16mhz8bit/stargazer/technical/main electronics board rendering.png

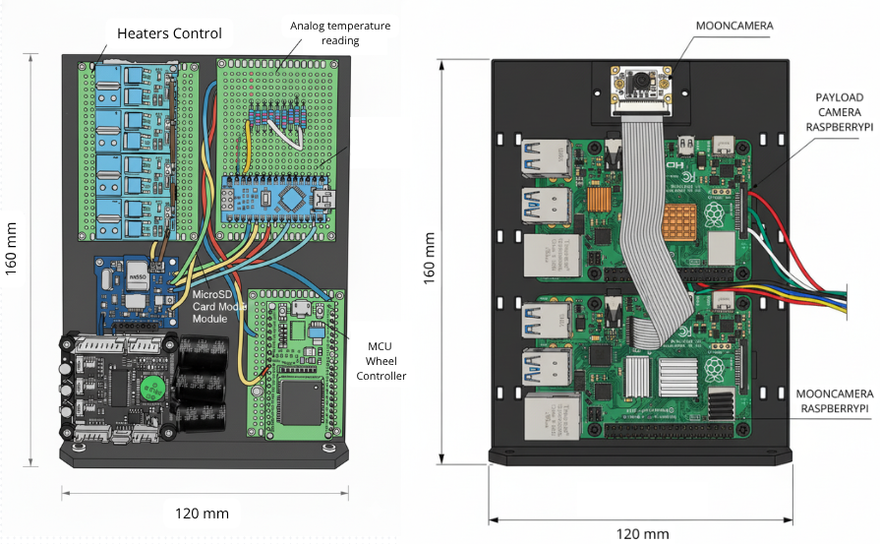
technical/main electronics board rendering.png
