16mhz8bit/stargazer/gallery/main_electronics_bay.jpg

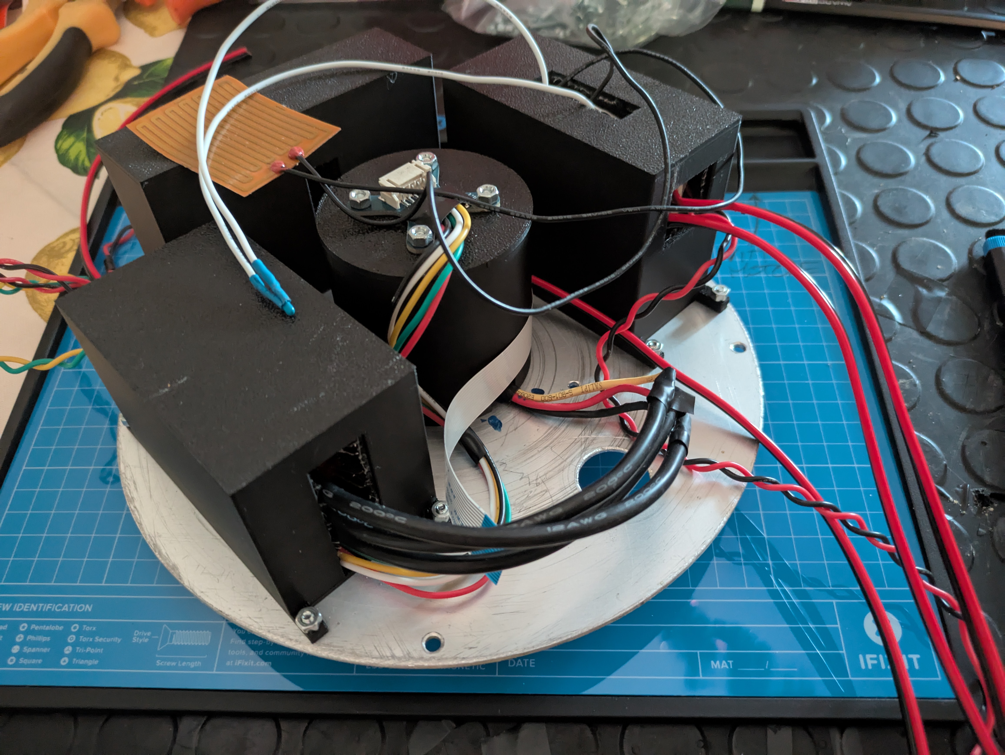
gallery/main_electronics_bay.jpg
