16mhz8bit/stargazer/README.md

# STARGAZER
Aggiungi un titolo (3)

## What's this?  
**STARGAZER** is a self-developed telescope project born from the dream of building a space telescope. 
With limited resources, we turned to high-altitude ballooning as the most accessible way to approach space-like observation conditions. 
Built with simplicity and robustness in mind, Stargazer aims to deliver meaningful scientific data while sharing every step openly to inspire and support the scientific and educational community.

## Sponsor  
Thanks to **SAPIO** for providing the gas for the mission!

logo_sapio
