16mhz8bit/stargazer/gallery/cameras.jpg

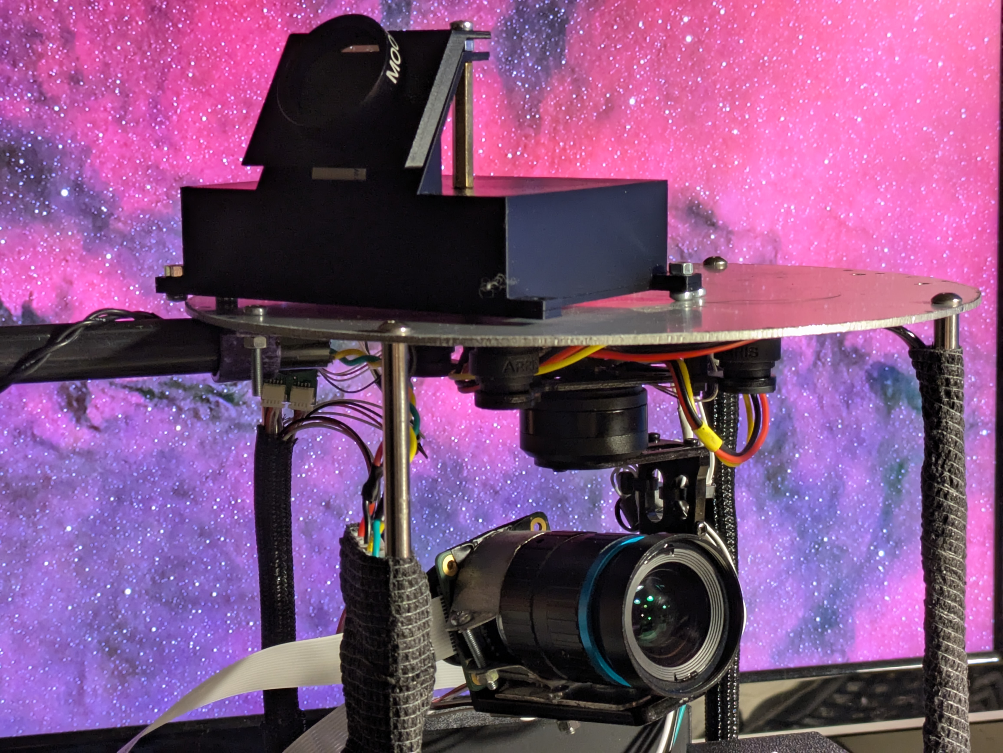
gallery/cameras.jpg
