16mhz8bit/stargazer/gallery/cover.png

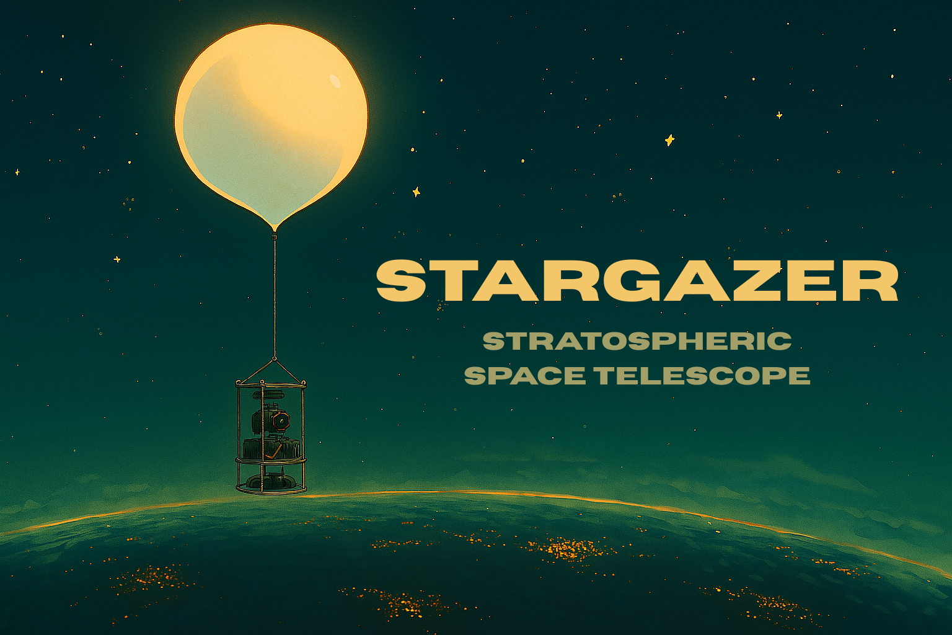
gallery/cover.png
