16mhz8bit/stargazer/gallery/moon_cam_dev.jpg

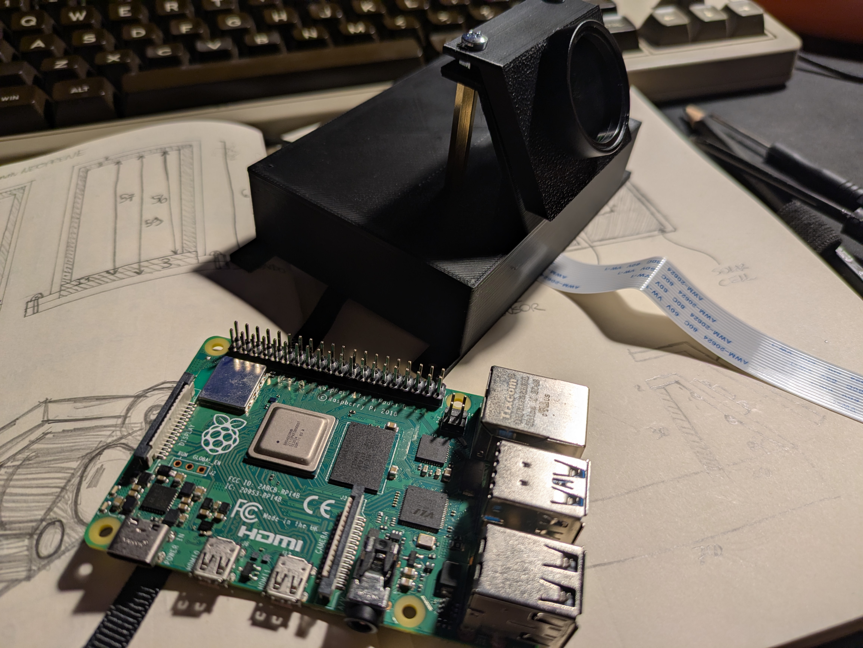
gallery/moon_cam_dev.jpg
