16mhz8bit/stargazer/gallery/power_supply_system.jpg

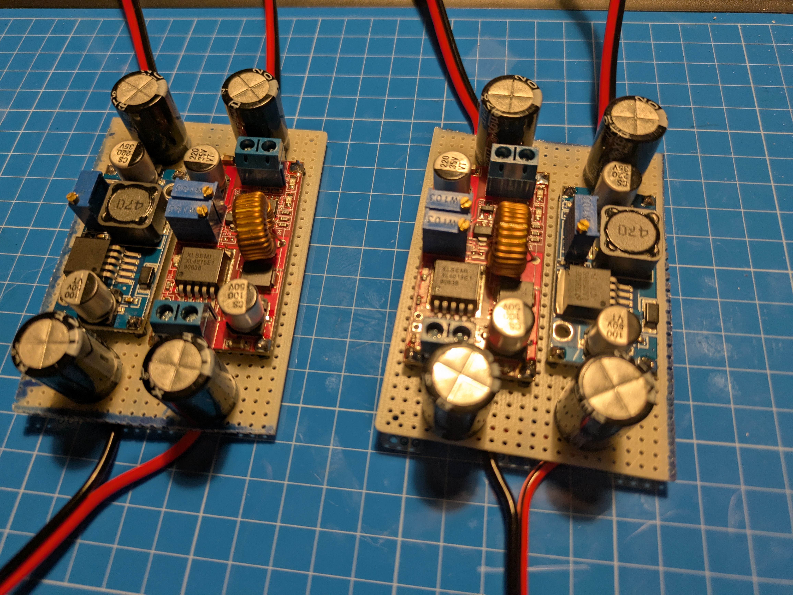
gallery/power_supply_system.jpg
