16mhz8bit/stargazer/gallery/stargazer_dev.jpg

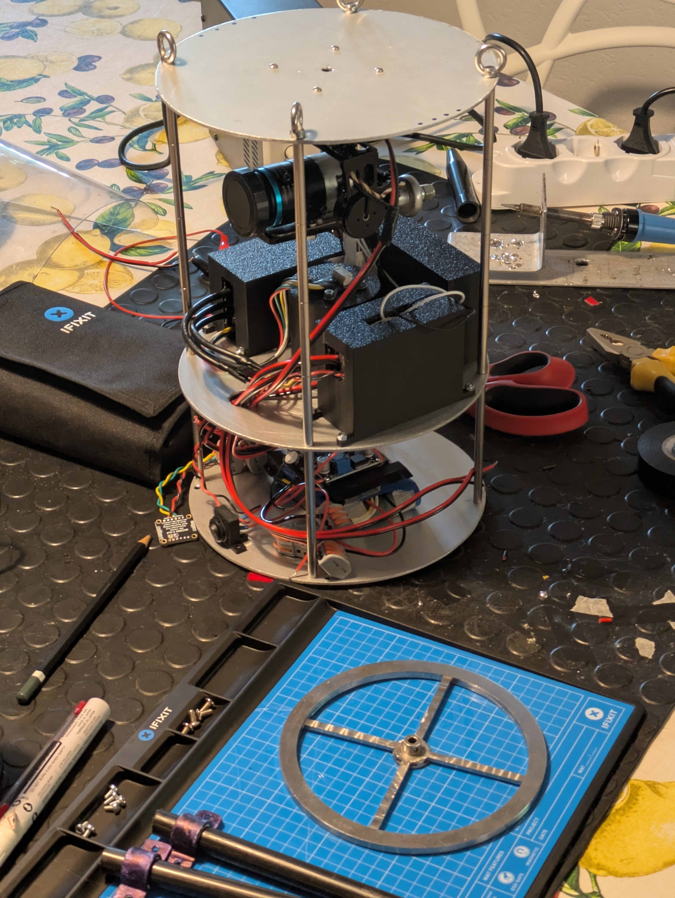
gallery/stargazer_dev.jpg
