16mhz8bit/stargazer/gallery/team_photo.jpg

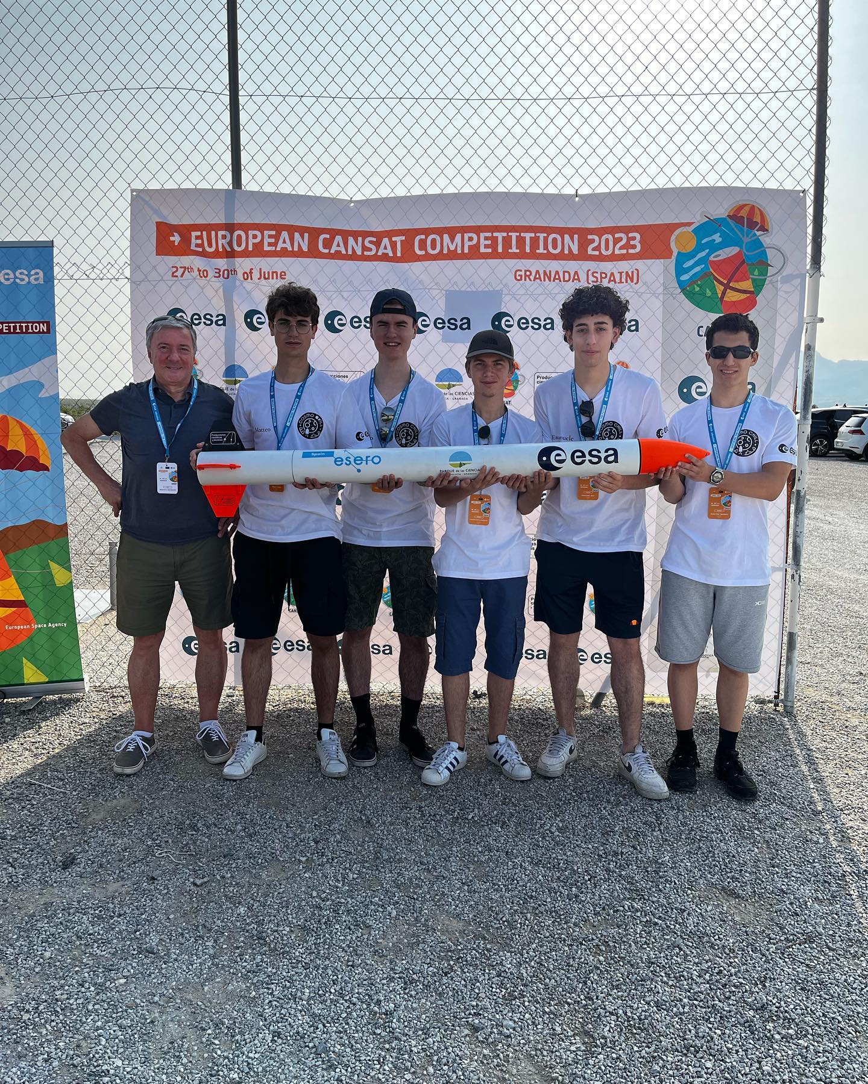
gallery/team_photo.jpg
