16mhz8bit/stargazer/gallery/team_rocket.jpg

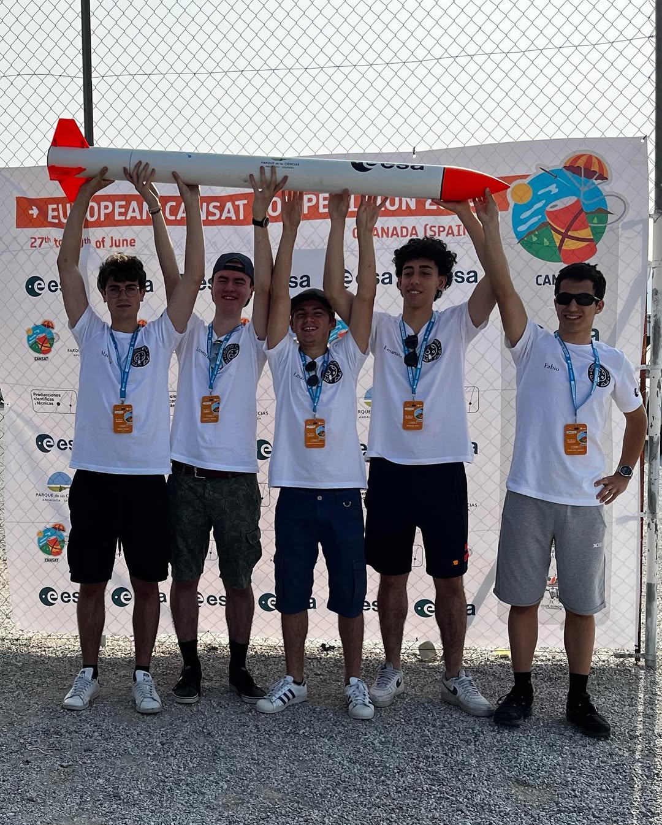
gallery/team_rocket.jpg
