16mhz8bit/stargazer/mooncamera/imgs/1.jpg

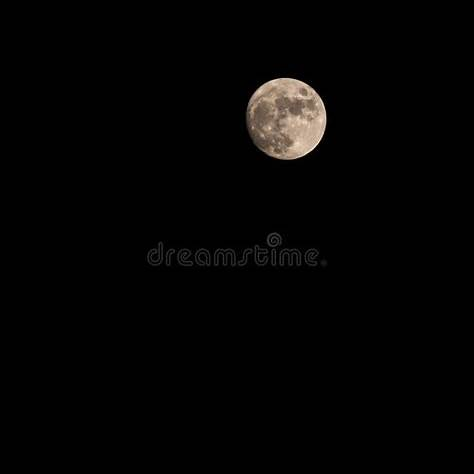
mooncamera/imgs/1.jpg
