16mhz8bit/stargazer/mooncamera/imgs/2.jpg

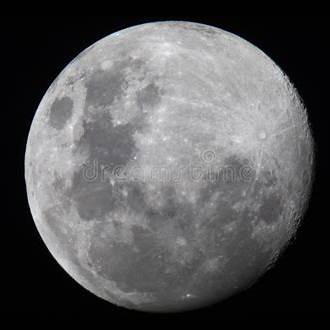
mooncamera/imgs/2.jpg
