16mhz8bit/stargazer/mooncamera/imgs/3.jpg

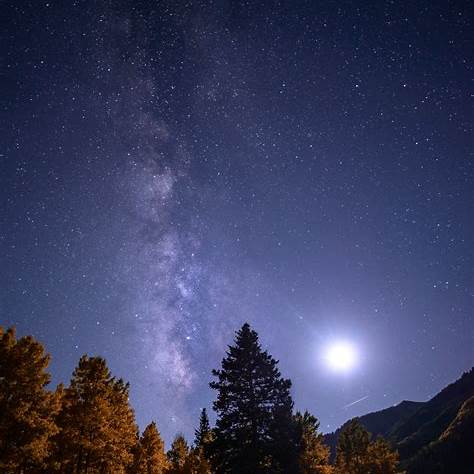
mooncamera/imgs/3.jpg
