16mhz8bit/stargazer/mooncamera/imgs/4.jpg

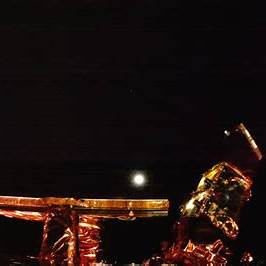
mooncamera/imgs/4.jpg
