16mhz8bit/stargazer/mooncamera/imgs/5.jpeg

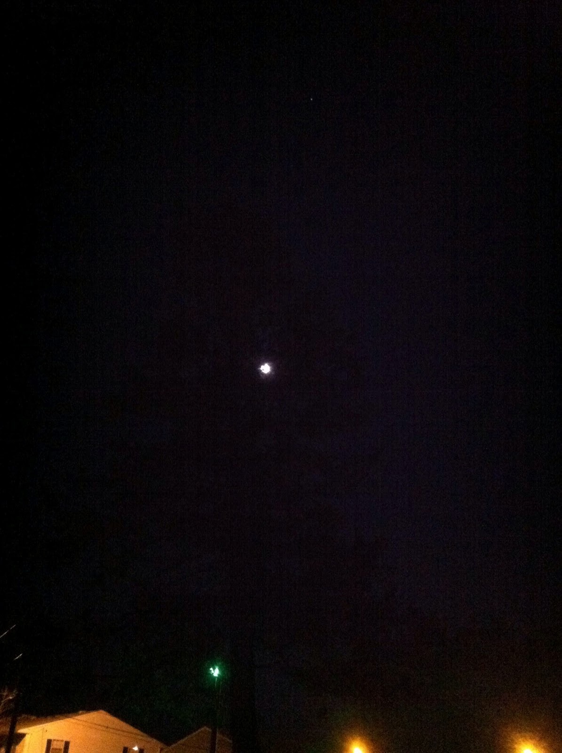
mooncamera/imgs/5.jpeg
