16mhz8bit/stargazer/mooncamera/imgs/7.jpeg

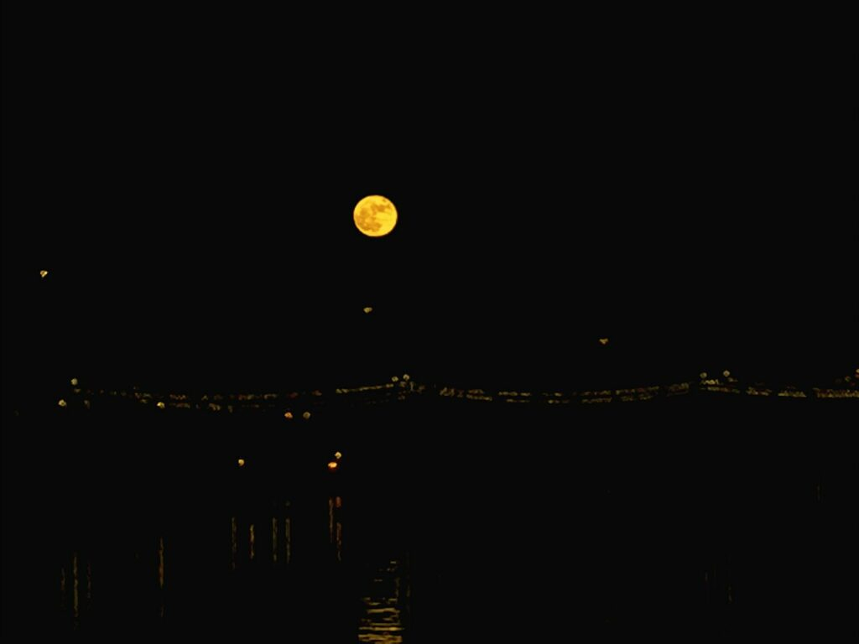
mooncamera/imgs/7.jpeg
