16mhz8bit/stargazer/mooncamera/imgs/8.jpeg

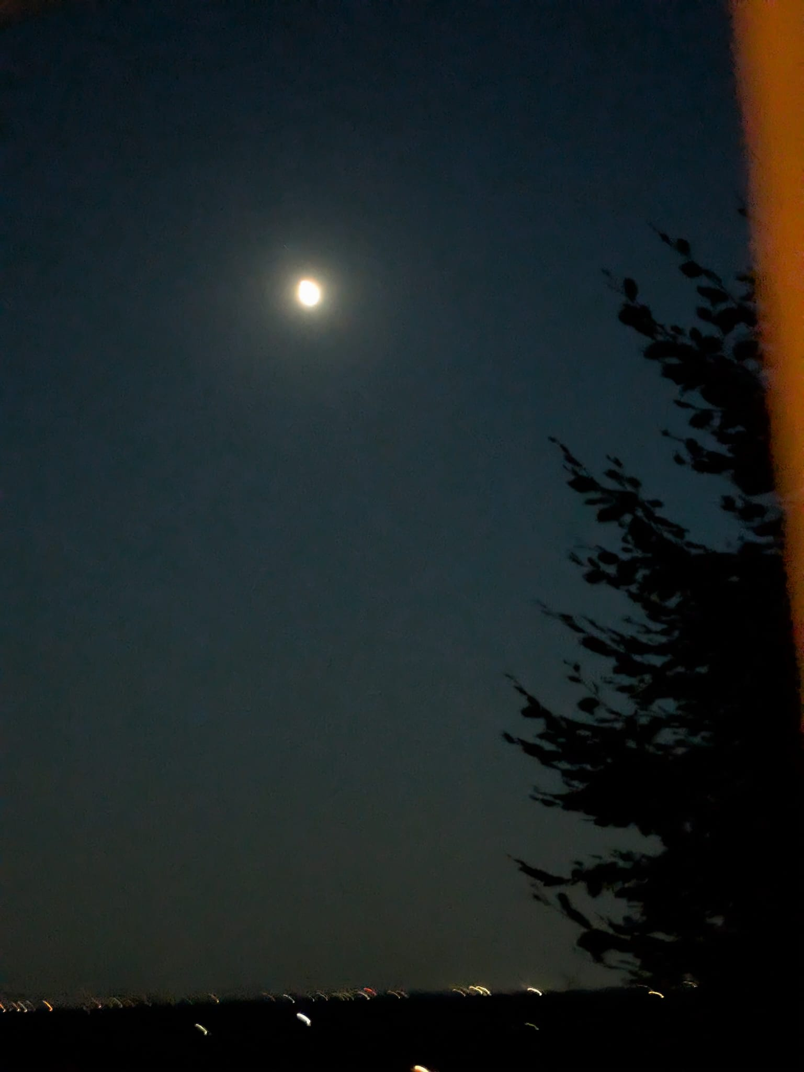
mooncamera/imgs/8.jpeg
