16mhz8bit/stargazer/mooncamera/imgs/9.jpeg

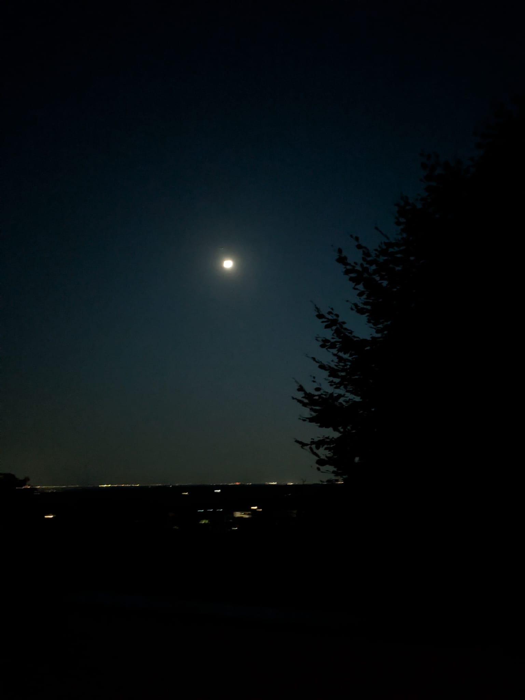
mooncamera/imgs/9.jpeg
