16mhz8bit/stargazer/mooncamera/imgs/11.jpeg

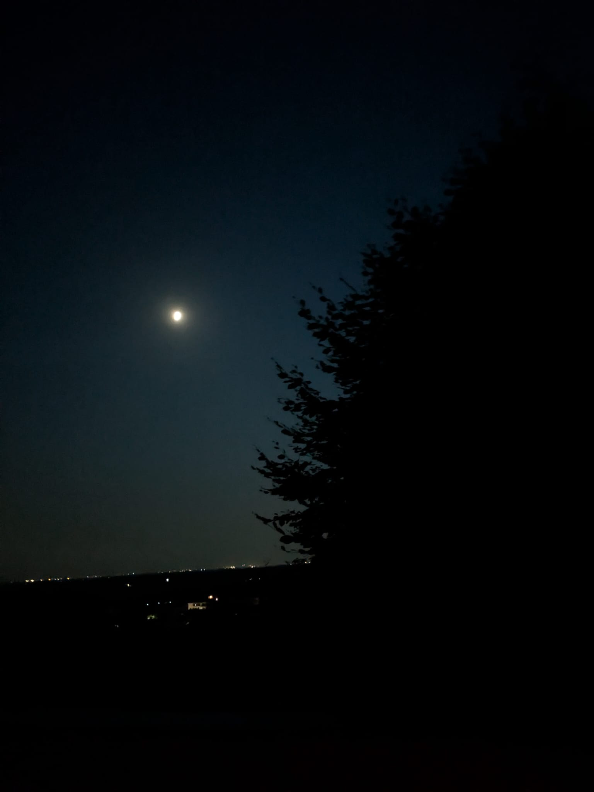
mooncamera/imgs/11.jpeg
