16mhz8bit/stargazer/mooncamera/imgs/12.jpeg

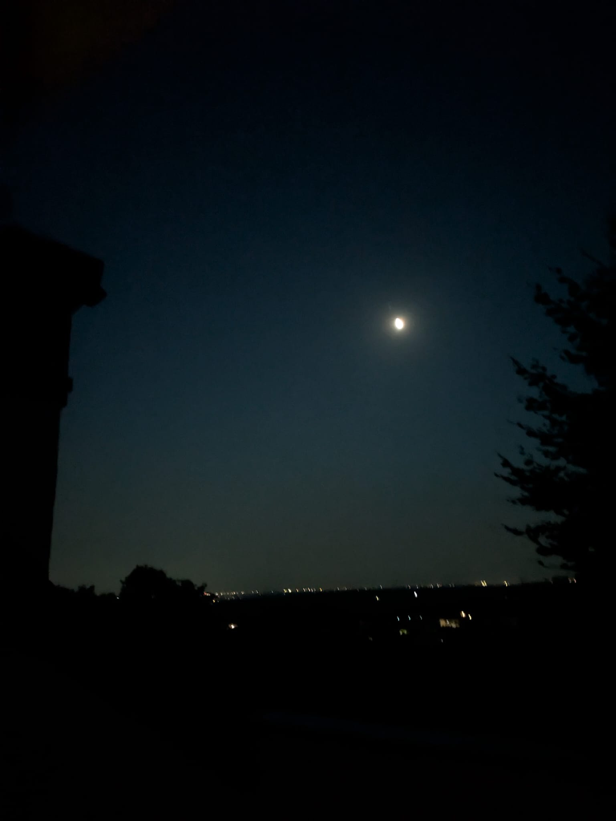
mooncamera/imgs/12.jpeg
