16mhz8bit/stargazer/mooncamera/imgs/13.jpeg

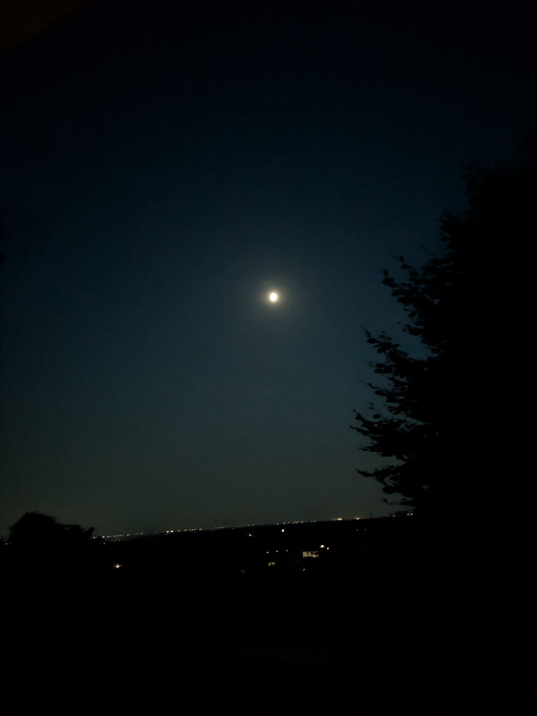
mooncamera/imgs/13.jpeg
