16mhz8bit/stargazer/mooncamera/imgs/14.jpeg

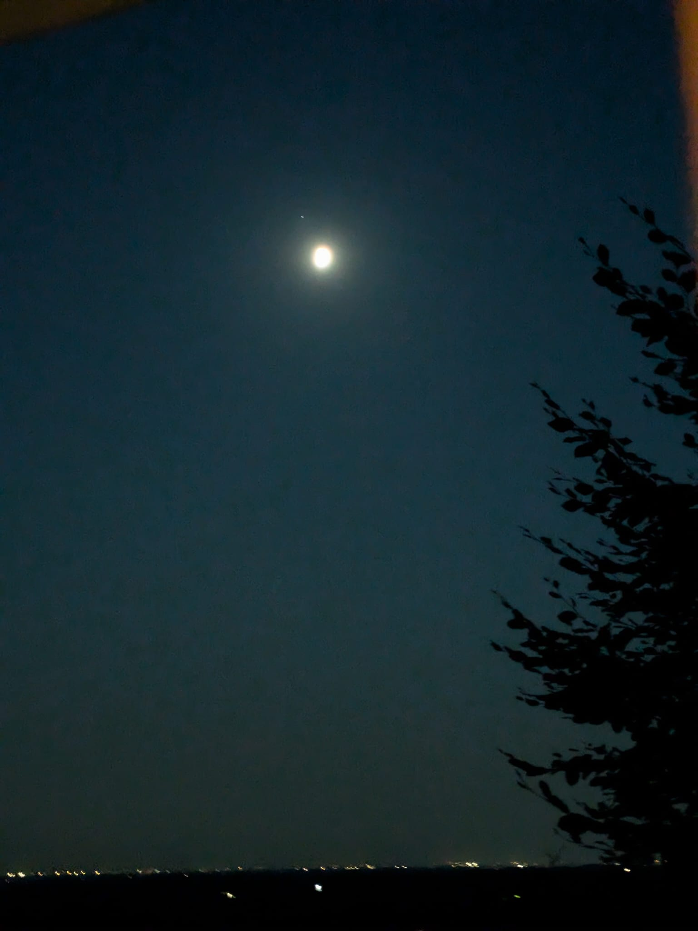
mooncamera/imgs/14.jpeg
