16mhz8bit/stargazer/technical/main electronics board.png

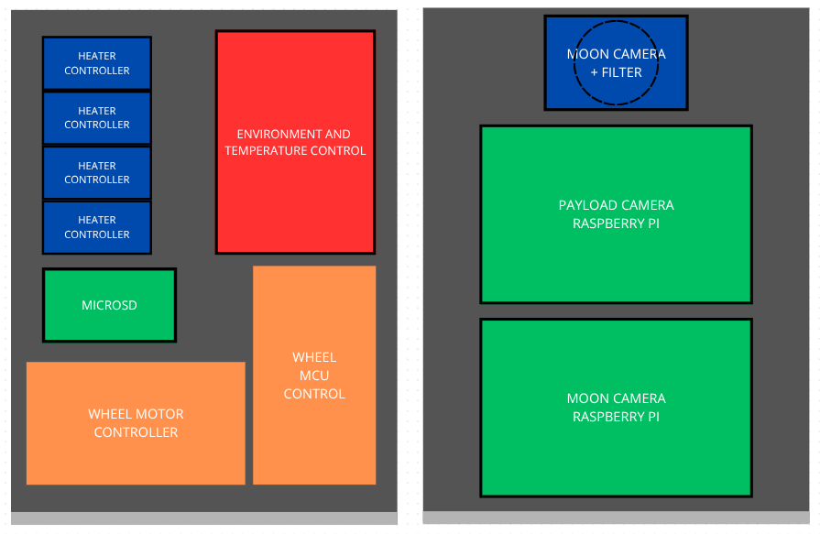
technical/main electronics board.png
