16mhz8bit/stargazer/technical/3D files/Wheel motor enclosure (with encoder holes).stl

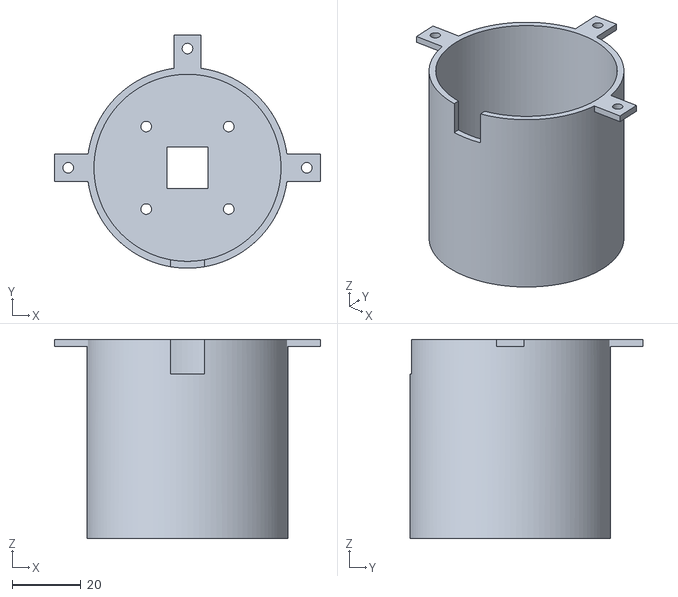
[picture p29: CAD file, 2025-10-27]
technical/3D files/Wheel motor enclosure (with encoder holes).stl
77.5 x 68.0 x 58.0
