16mhz8bit/stargazer/technical/3D files/Board for cameras electronics.stl

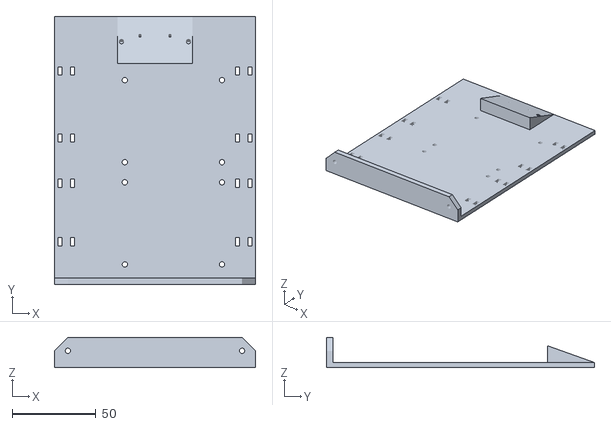
[picture p30: CAD file, 2025-10-27]
technical/3D files/Board for cameras electronics.stl
120.0 x 160.0 x 18.0
