16mhz8bit/stargazer/technical/3D files/Board for control electronics.stl

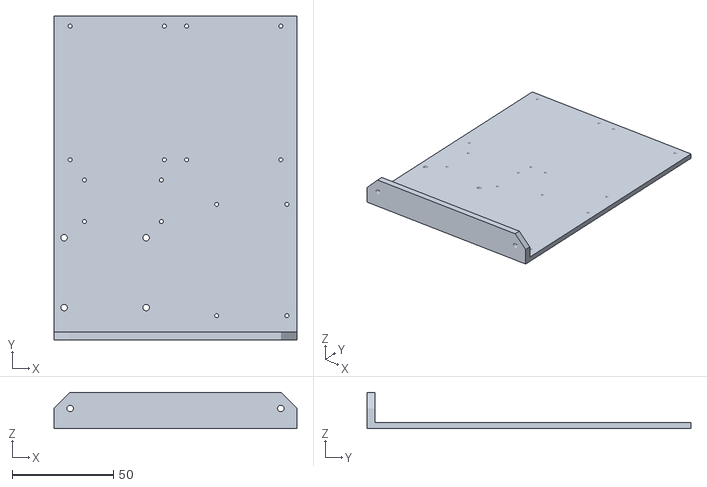
[picture p31: CAD file, 2025-10-27]
technical/3D files/Board for control electronics.stl
120.0 x 160.0 x 18.0
