16mhz8bit/stargazer/technical/3D files/Moon filter for moon camera adapter.stl

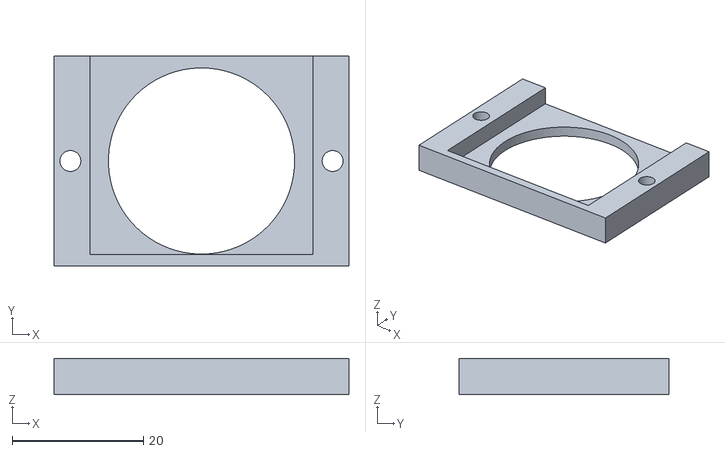
[picture p32: CAD file, 2025-10-27]
technical/3D files/Moon filter for moon camera adapter.stl
45.0 x 32.0 x 5.50
