16mhz8bit/stargazer/technical/3D files/Encoder magnet adapter for C4250 BLDC.stl

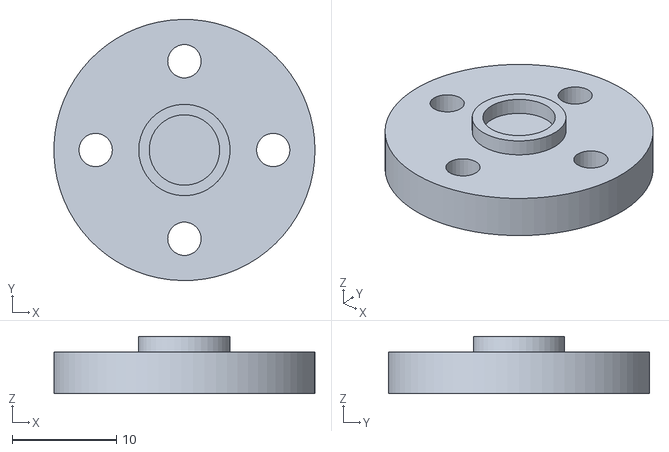
[picture p33: CAD file, 2025-10-27]
technical/3D files/Encoder magnet adapter for C4250 BLDC.stl
25.0 x 25.0 x 5.50
