16mhz8bit/stargazer/technical/3D files/Reaction Wheel 3D file.step

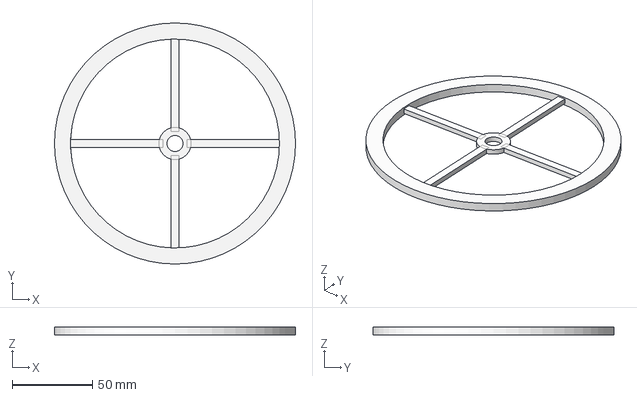
[picture p34: CAD file, 2025-10-27]
technical/3D files/Reaction Wheel 3D file.step
150.0 x 150.0 x 5.00 mm
