16mhz8bit/stargazer/gallery/first_camera_test.png

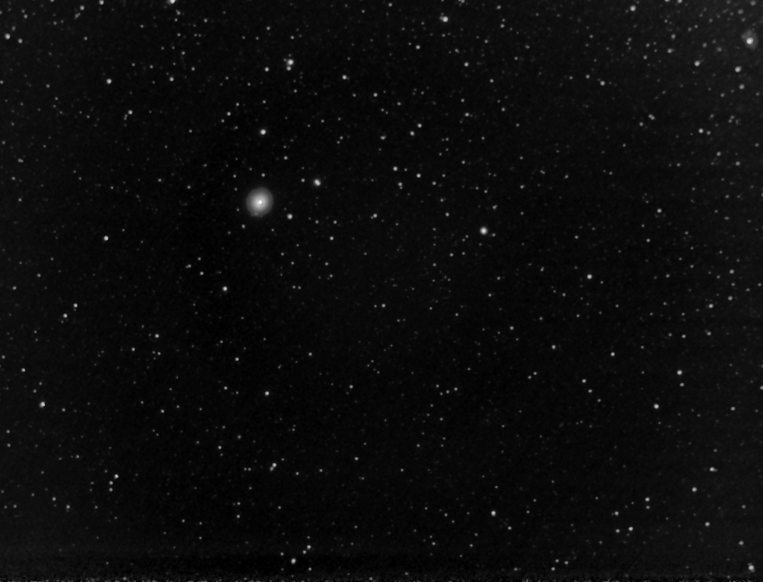
gallery/first_camera_test.png
